aleksey00/dust-fairy/Dust-Fairy.png

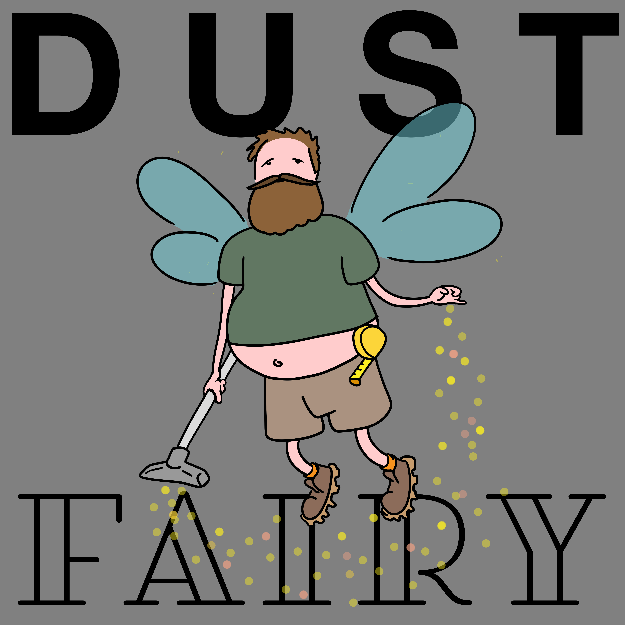
Dust-Fairy.png
