aleksey00/dust-fairy/media/wire_pull_wide.gif

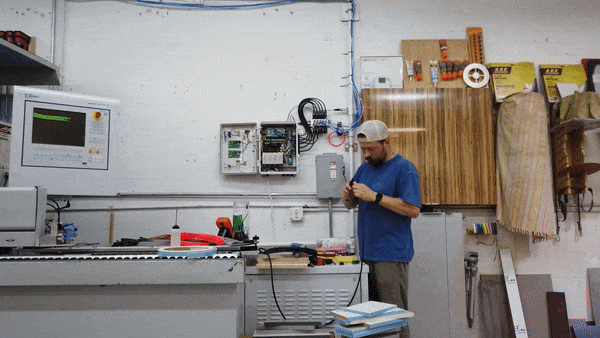
media/wire_pull_wide.gif
