aleksey00/dust-fairy/schematic/ArduinoBoxDiagram/circuit.png

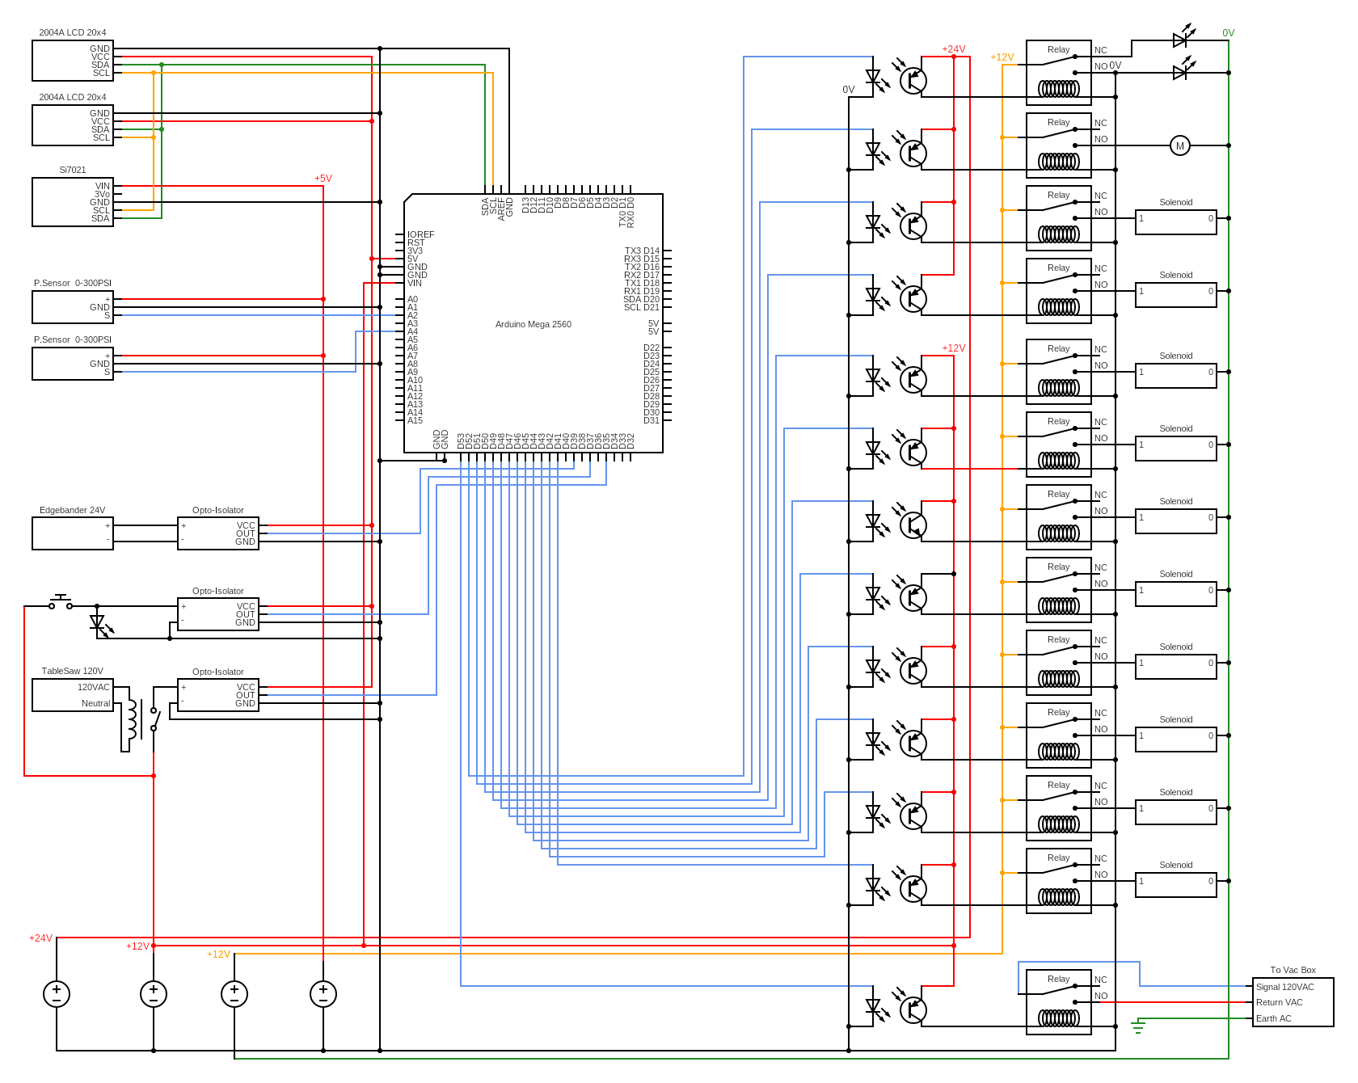
schematic/ArduinoBoxDiagram/circuit.png
