aleksey00/dust-fairy/schematic/ArduinoBoxDiagram/circuit_dark.png

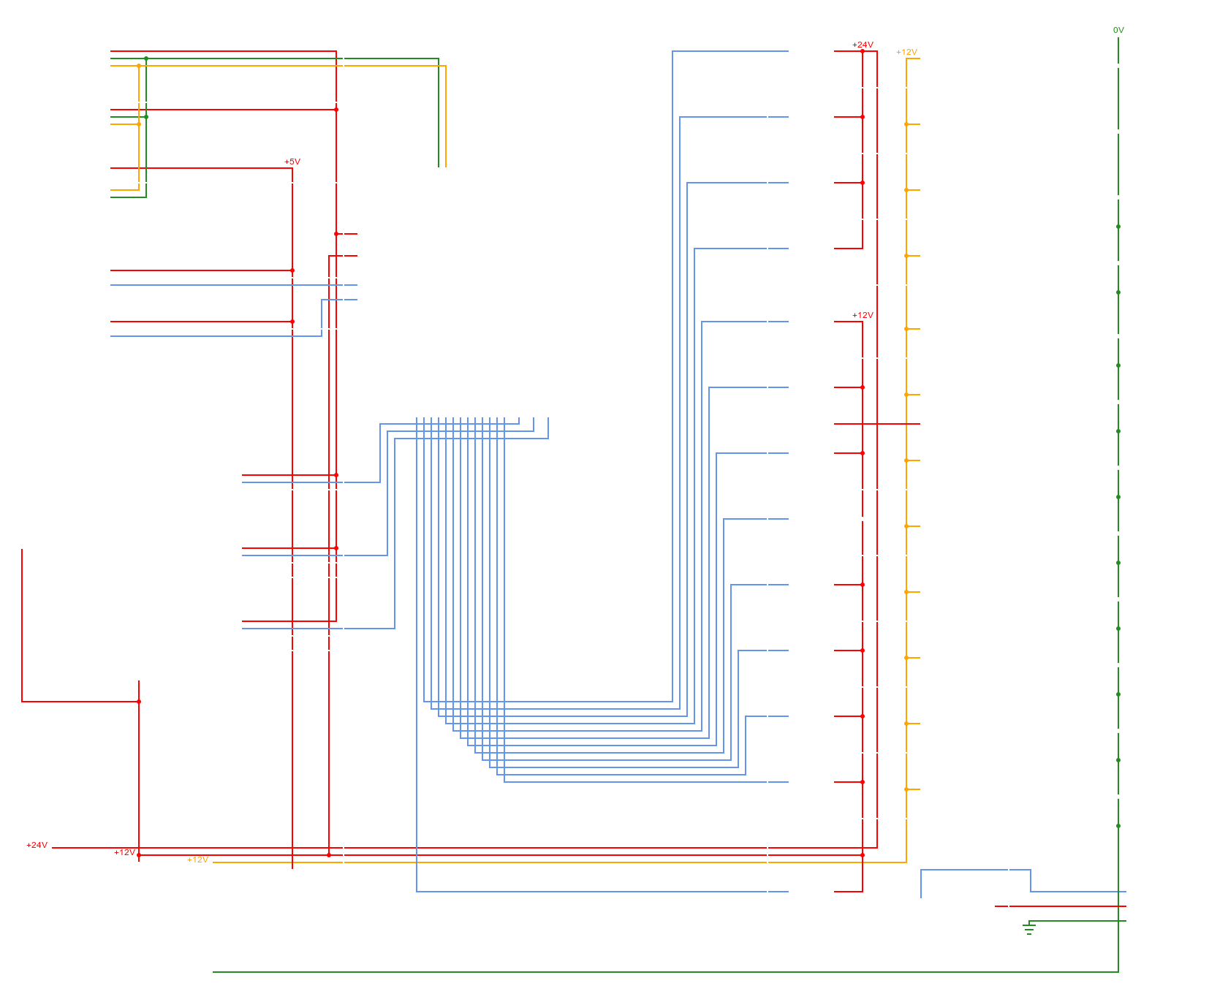
schematic/ArduinoBoxDiagram/circuit_dark.png
