aleksey00/dust-fairy/schematic/ArduinoBoxDiagram/circuit_light.png

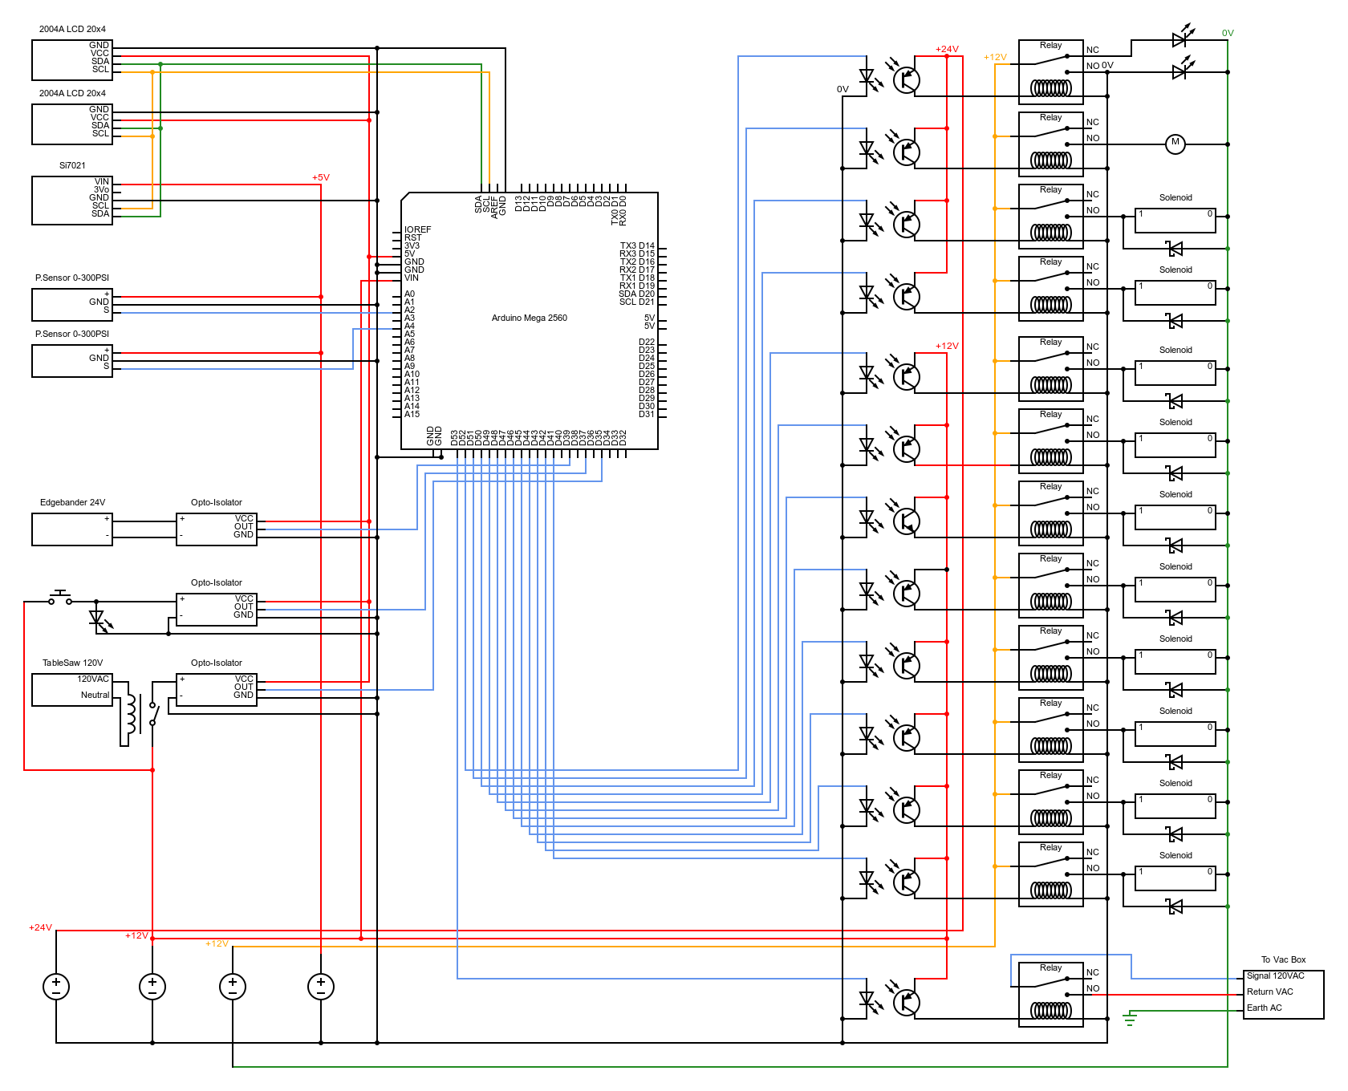
schematic/ArduinoBoxDiagram/circuit_light.png
