aleksey00/dust-fairy/schematic/VacBoxDiagram/circuit.png

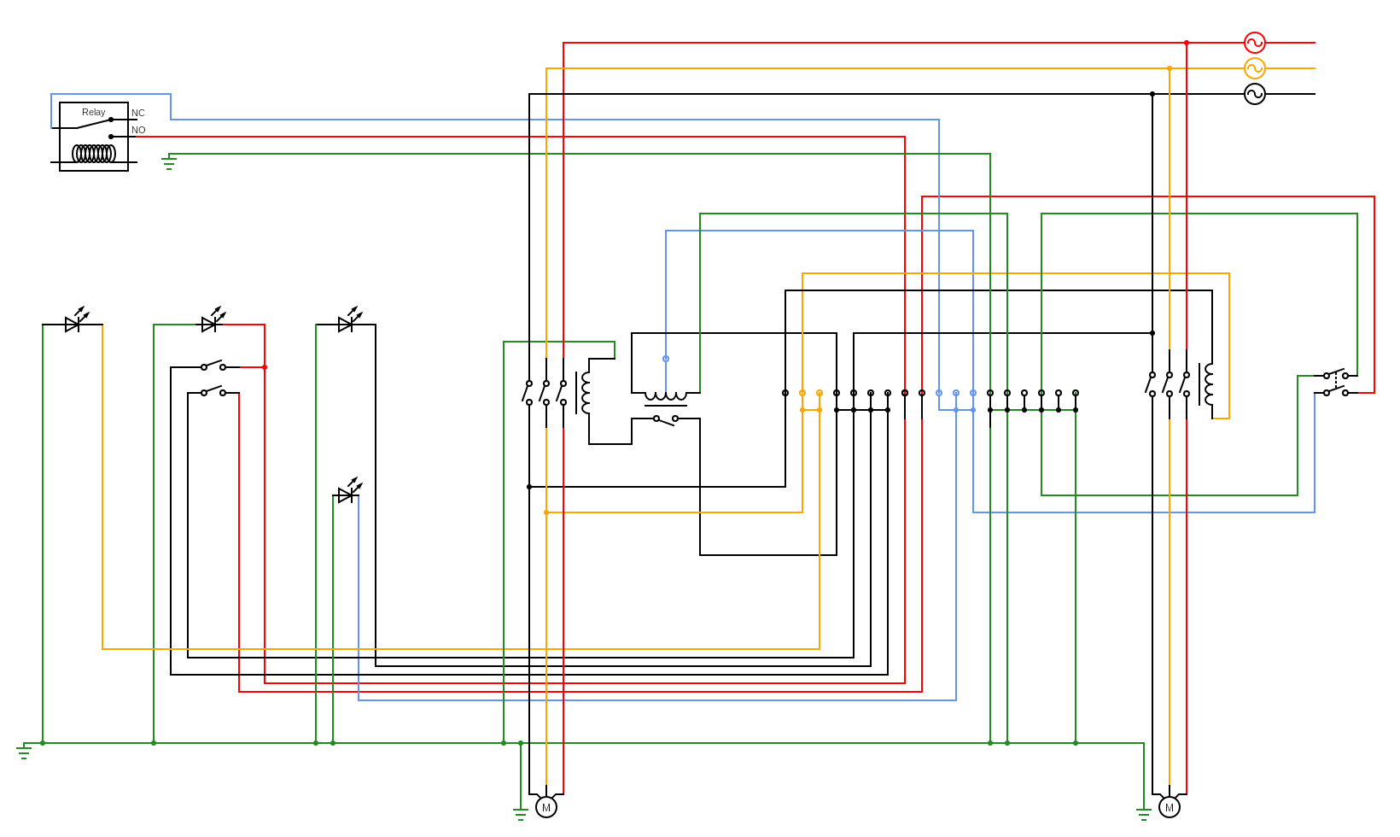
schematic/VacBoxDiagram/circuit.png
