aleksey00/dust-fairy/schematic/VacBoxDiagram/circuit_dark.png

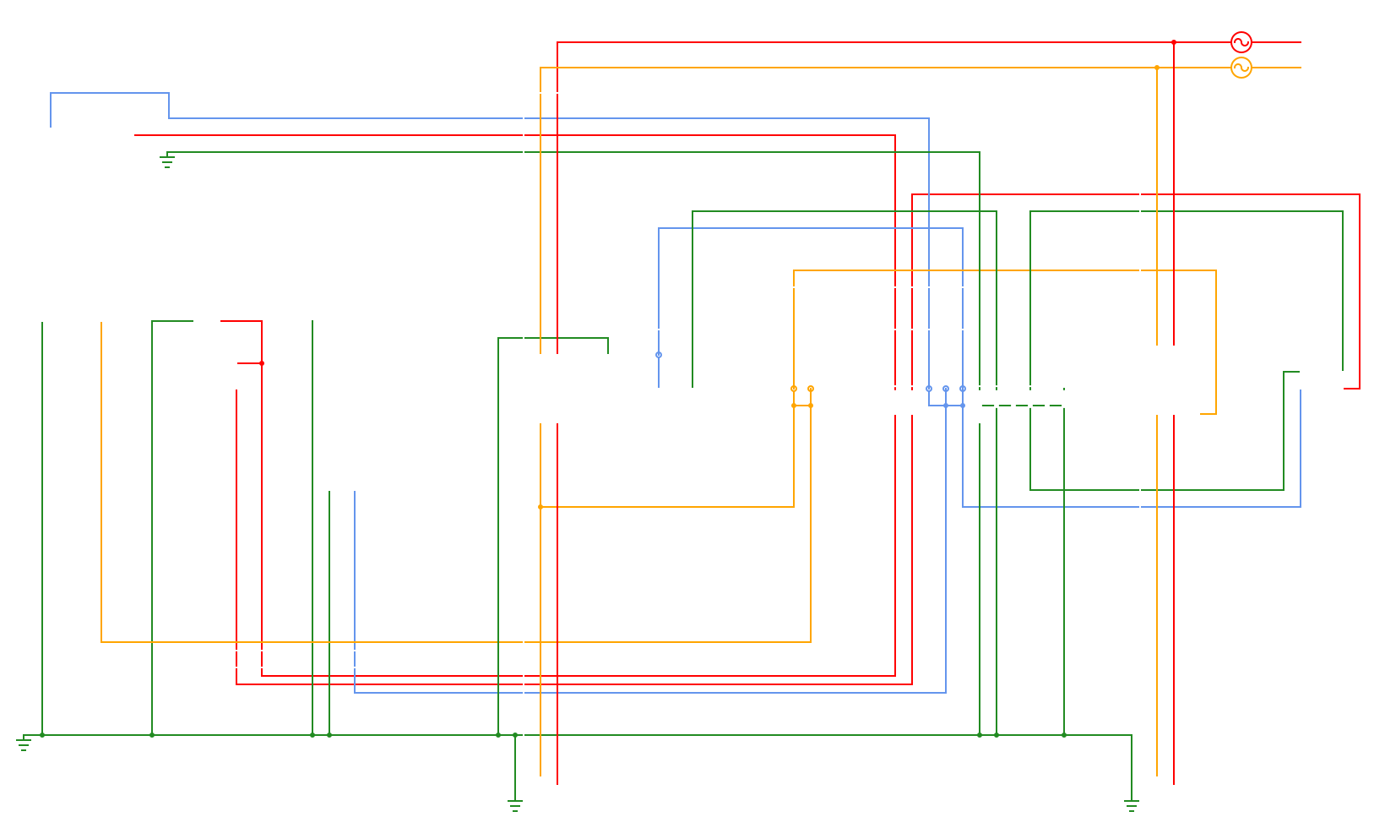
schematic/VacBoxDiagram/circuit_dark.png
