aleksey00/dust-fairy/Dust_Fairy_1_4_clean/solenoids.h

#ifndef SOLENOIDS_H
#define SOLENOIDS_H

#include <Wire.h>
#include "Arduino.h"
#include "startLCD.h"
#include "humanTime.h"
#include "vacuum.h"

/*
solenoids, working pressure 14psi to 114psi
*/

const int gateE8Open = 41;                          // Endgebander 8" Gate Open Solenoid
const int gateE8Close = 50;                         // Endgebander 8" Gate Close Solenoid
const int gateE4Open = 43;                          // Endgebander 4" Gate Open Solenoid
const int gateE4Close = 48;                         // Endgebander 4" Gate Close Solenoid
const int gateE5Open = 45;                          // Endgebander 5" Gate Open Solenoid
const int gateE5Close = 46;                         // Endgebander 5" Gate Close Solenoid
const int gateTableSawOpen = 47;                    // Table Saw   5" Gate Open Solenoid
const int gateTableSawClose = 44;                   // Table Saw   5" Gate Close Solenoid
const int solenoid1 = 42;                           // solenoids with disconnected air
const int solenoid2 = 49;                           // solenoids with disconnected air
const int coolingFan = 51;                          // cooling fan for electonics box
const int okStop = 52;                              // OK/STOP lights NO/NC
const int vacuum = 53;                              // Dust-collector contactor ON/OFF solenoid

extern void analogPinsSetup();                      // Analog pins initialization INPUT 5, 11
extern void digitalPinsSetup(int first, int last);  // Digital pins initialization OUTPUT 41 -53
extern void digitalPinsInputSetup(bool serial);     // Digital pins initializaion INPUT (serial feedback on/off)
extern void gateTest(int n, int val);               // Method used to activate gates with visual feedback to LCD

#endif

// LCD1
// LCD2

// Time ON: 00:00:00.00
// Solenoids:  00.0 psi
// Main pipe: 000.0 psi
// 00.0'C 00.0F 00.0% #

// 01234567890123456789

// E. 8"OOX 4"OOX PMOOX
// T.SawOOX Manual ONFF
// Dust Collector ONOFF
// RUN:Y:   00:00:00.00
