aleksey00/dust-fairy/(commit log)

2022-05-19 Arduino code uploaded
2022-09-29 pressureSensor.cpp .h comments
2022-09-29 solenoids.cpp + .h rearrange, edit and comment cleanup
2022-09-29 solenoids.h deleted useless lines and renamed okStop pin 52
2022-09-29 deleted pinAct function that used old solenoid# values from solenoids.cpp
2022-09-30 Added arduino in list
2022-10-03 Temp fan function, added table saw only open switch case, safety feature for vac manual on
2022-10-04 update with solenoids numbers
2022-10-10 lcd wiring in
2022-10-11 LCD cut gif
2022-10-21 Schematic diagram upload
2022-10-22 schematic diagrams
2022-11-22 Update - Schottky solenoid for Arduino box schematic
2022-11-25 Schottky diode schematic diagram update
