aleksey00/dust-fairy/(notices)

Notices in the files:
README.md:
LICENSE:
GitHub MIT license
Table of content:
- Logo
- Abstract
- Introduction
- Idea
- Components
- Schematic Diagrams
